benheck/xb1cm2018/README.md

# xb1cm2018
Source code and support files for the Xbox 1 Controller Monitor 2018 model.

Code version 005 has support for PS4 mode. User can change what mode the monitor is in by holding USER button on boot to swap modes. Current mode is stored in EEPROM so you.

For more information visit www.benheck.com/xb1monitor2
